montana-science-center/exhibit-laser-music-instrument/mechanical/ToF enclosure IR window holder.3mf

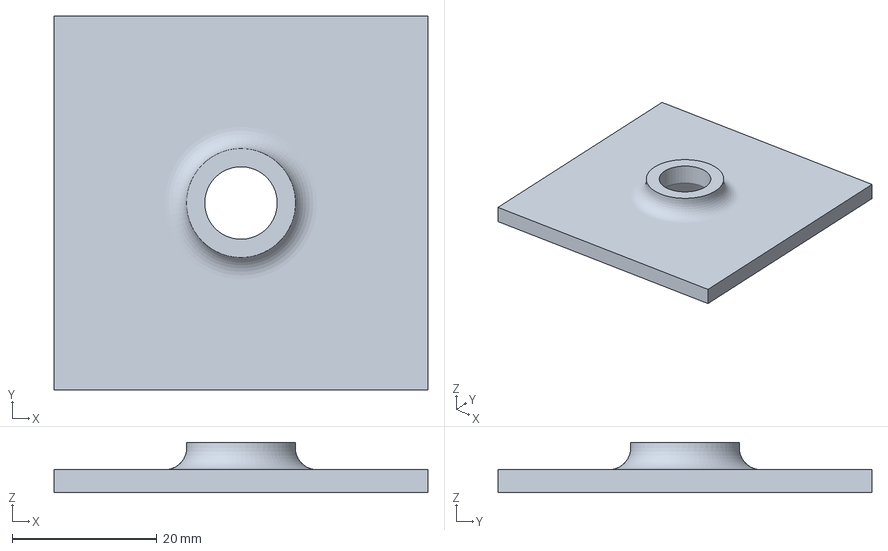
[picture p1: CAD file, 2022-08-08]
mechanical/ToF enclosure IR window holder.3mf
51.6 x 51.6 x 6.96 mm
