montana-science-center/exhibit-laser-music-instrument/pcb/phototransistor-circuit/phototransistor-circuit.step

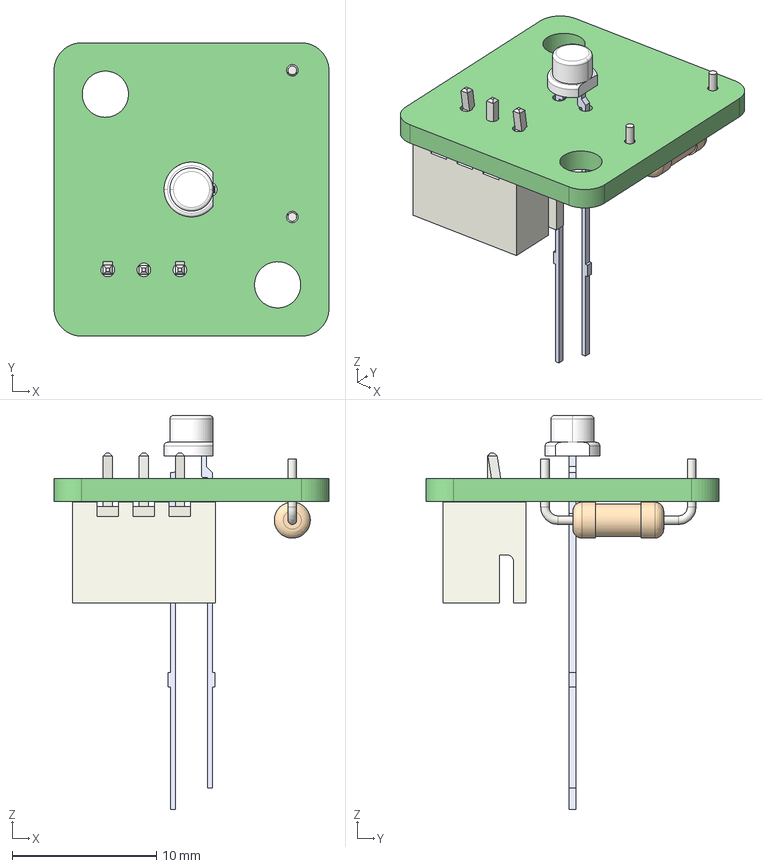
[picture p2: CAD file, 2022-05-28]
pcb/phototransistor-circuit/phototransistor-circuit.step
19.1 x 20.3 x 27.3 mm
phototransistor-circuit PCB
