montana-science-center/exhibit-laser-music-instrument/mechanical/ToF whammy bar enclosure.3mf

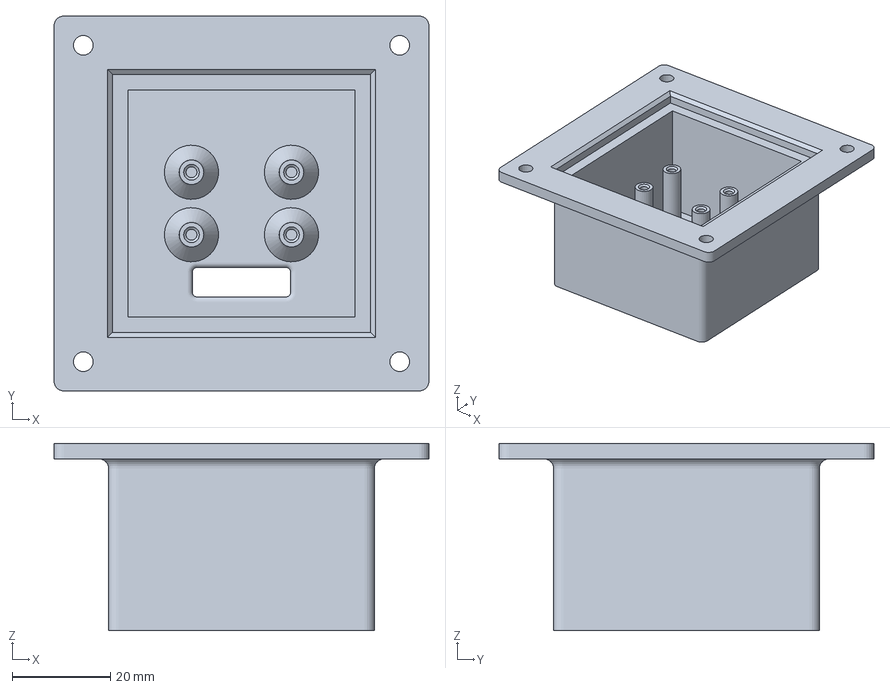
[picture p3: CAD file, 2022-08-08]
mechanical/ToF whammy bar enclosure.3mf
76.2 x 76.2 x 38.1 mm
