montana-science-center/exhibit-laser-music-instrument/mechanical/ToF whammy bar enclosure v5.3mf

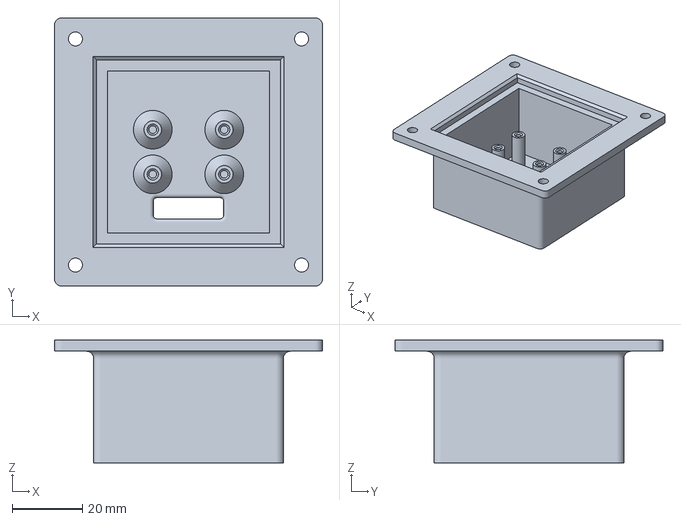
[picture p4: CAD file, 2022-08-08]
mechanical/ToF whammy bar enclosure v5.3mf
76.2 x 76.2 x 34.9 mm
