montana-science-center/exhibit-laser-music-instrument/mechanical/ToF whammy bar enclosure v3.step

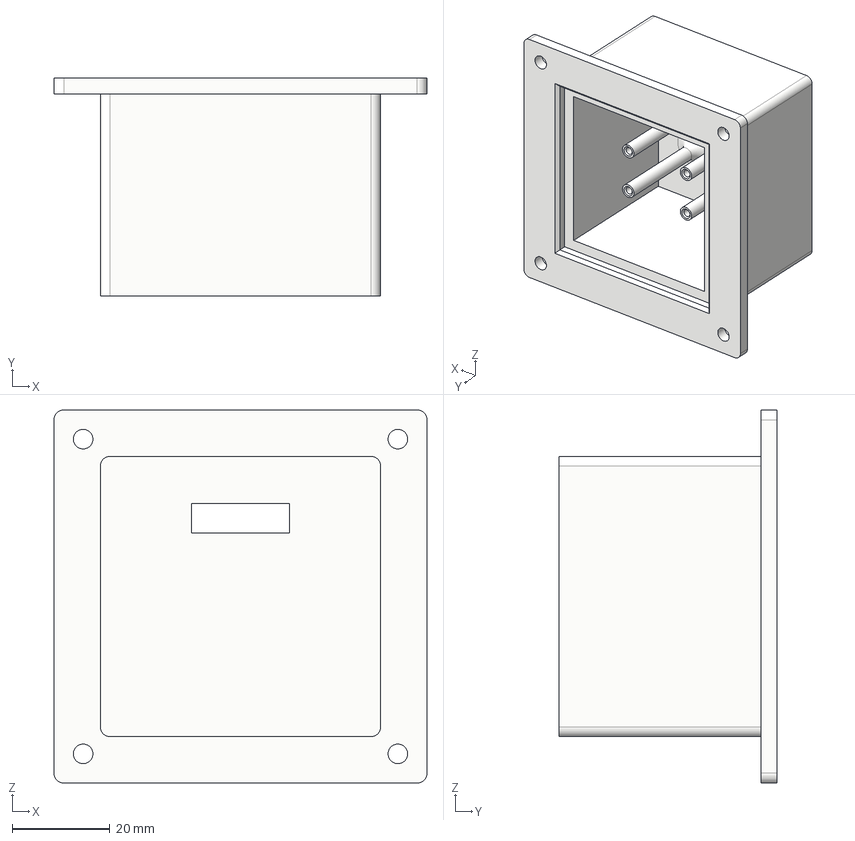
[picture p5: CAD file, 2022-08-08]
mechanical/ToF whammy bar enclosure v3.step
76.2 x 44.5 x 76.2 mm
