montana-science-center/exhibit-laser-music-instrument/mechanical/laser-module-holder-vlm-520-01-lpt.stl

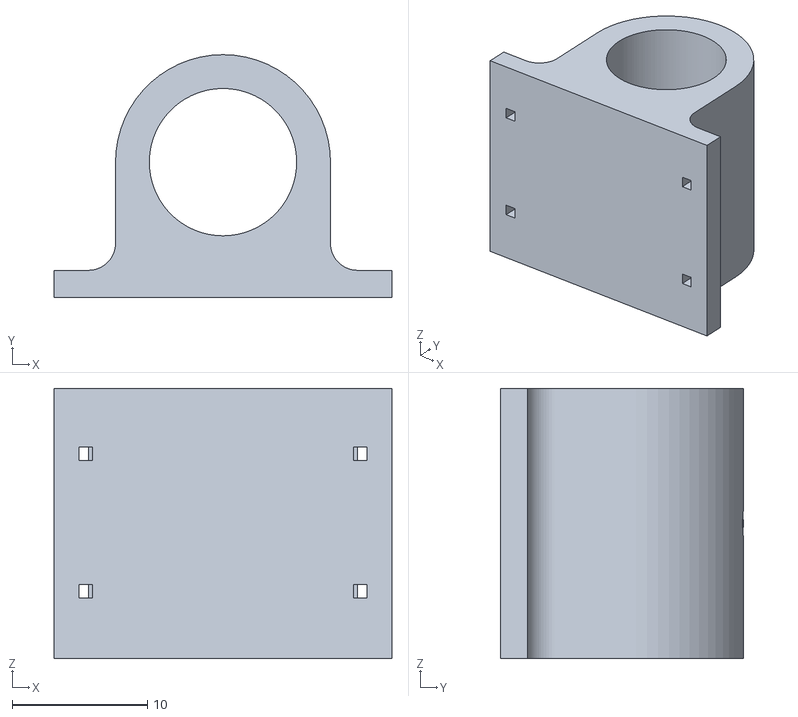
[picture p6: CAD file, 2022-05-13]
mechanical/laser-module-holder-vlm-520-01-lpt.stl
25.0 x 18.0 x 20.0
