montana-science-center/exhibit-laser-music-instrument/(list of files, cad)

Other CAD files:
mechanical/ToF whammy bar enclosure v6.stl
mechanical/5396 Adafruit VL53L4CD.f3d
mechanical/ToF enclosure IR window holder.stl
mechanical/ToF whammy bar enclosure v3.stl
mechanical/ToF whammy bar enclosure v5.stl
