montana-science-center/exhibit-laser-music-instrument/pcb/mainboard/mainboard.kicad_pcb

## KiCad design pcb/mainboard/mainboard.kicad_pcb (2022-06-05)

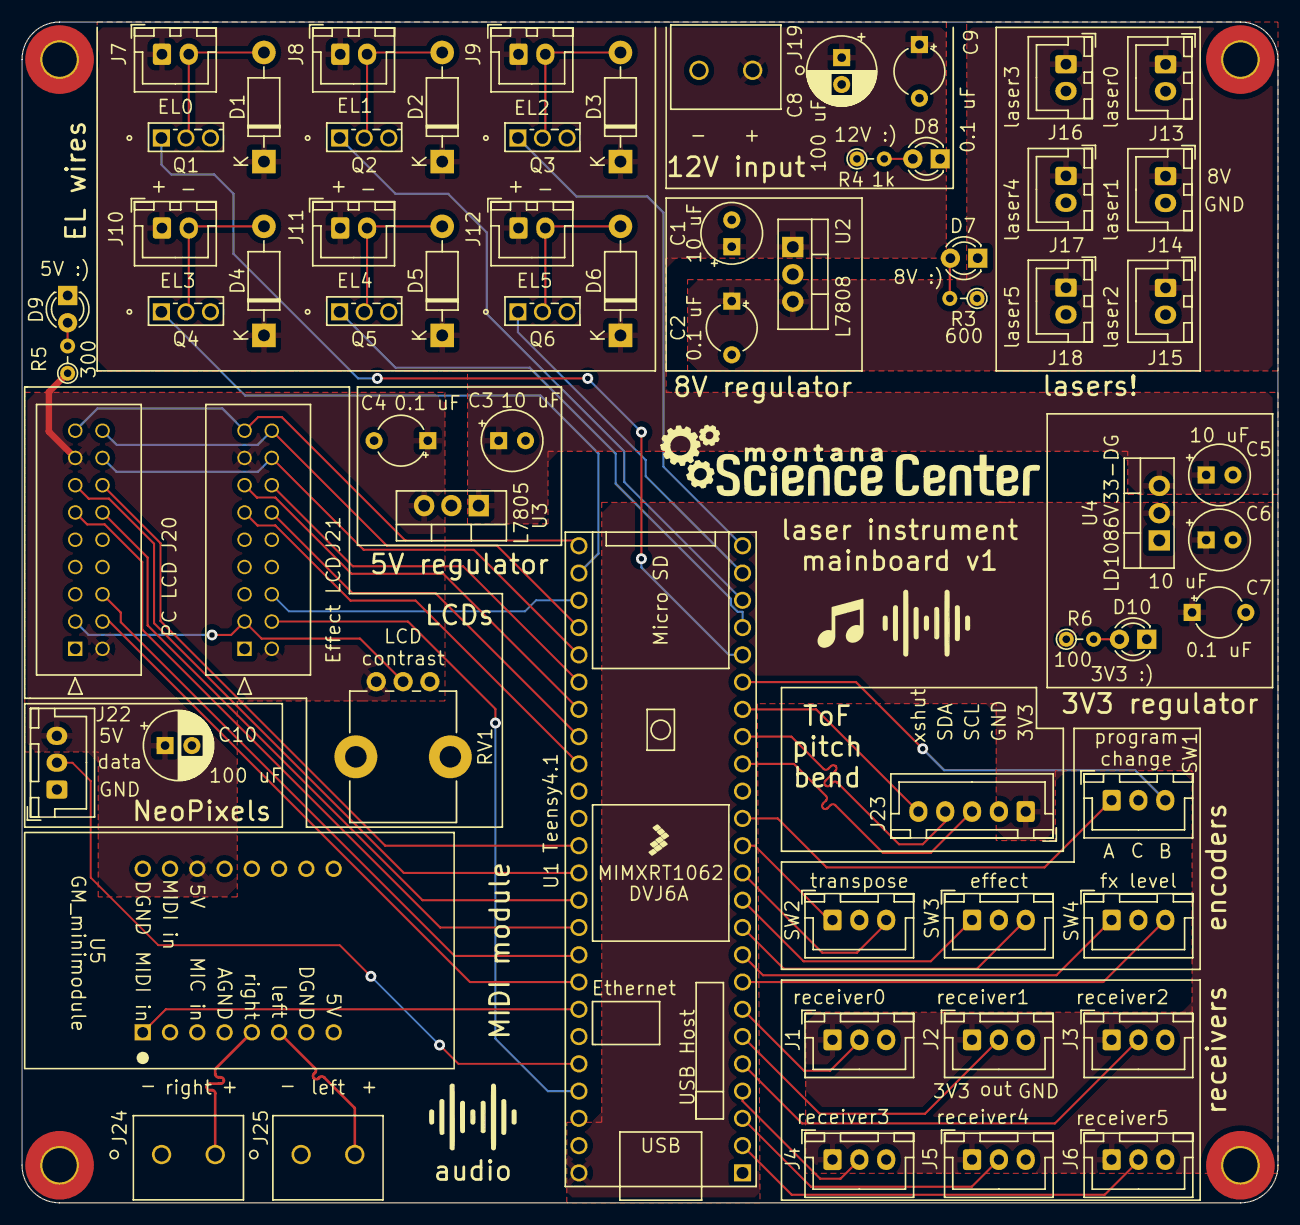
[picture p9: board mainboard.kicad_pcb from above]

Board: 2 copper layers, 117.0 x 110.0 mm, 69 parts (0 on the bottom side), 58 nets.

Parts:
C1, C3, C5, C6: 10 uF; CP_Radial_Tantal_D5.5mm_P2.50mm
C2, C4, C7, C9: 0.1 uF; CP_Radial_Tantal_D4.5mm_P5.00mm
C8, C10: 100 uF; CP_Radial_D6.3mm_P2.50mm
D1, D2, D3, D4, D5, D6: 1N4001; D_DO-41_SOD81_P10.16mm_Horizontal
D7, D8, D9, D10: LED; LED_D3.0mm_Clear
H1, H2, H3, H4: MountingHole_Pad; MountingHole_3.2mm_M3_Pad_TopBottom
J1: receiver0; JST_XH_B3B-XH-A_1x03_P2.50mm_Vertical
J2: receiver1; JST_XH_B3B-XH-A_1x03_P2.50mm_Vertical
J3: receiver2; JST_XH_B3B-XH-A_1x03_P2.50mm_Vertical
J4: receiver3; JST_XH_B3B-XH-A_1x03_P2.50mm_Vertical
J5: receiver4; JST_XH_B3B-XH-A_1x03_P2.50mm_Vertical
J6: receiver5; JST_XH_B3B-XH-A_1x03_P2.50mm_Vertical
J7, J8, J9, J10, J11, J12: el_connector; JST_XH_B2B-XH-A_1x02_P2.50mm_Vertical
J13: laser0; JST_XH_B2B-XH-A_1x02_P2.50mm_Vertical
J14: laser1; JST_XH_B2B-XH-A_1x02_P2.50mm_Vertical
J15: laser2; JST_XH_B2B-XH-A_1x02_P2.50mm_Vertical
J16: laser3; JST_XH_B2B-XH-A_1x02_P2.50mm_Vertical
J17: laser4; JST_XH_B2B-XH-A_1x02_P2.50mm_Vertical
J18: laser5; JST_XH_B2B-XH-A_1x02_P2.50mm_Vertical
J19: 12V_input; Wurth-691137710002
J20: PC LCD; Molex-901301118
J21: Effect LCD; Molex-901301118
J22: NeoPixel connector; JST_XH_B3B-XH-A_1x03_P2.50mm_Vertical
J23: VL53L4CD connector; JST_XH_B5B-XH-A_1x05_P2.50mm_Vertical
J24: right_audio; Wurth-691137710002
J25: left_audio; Wurth-691137710002
Q1, Q2, Q3, Q4, Q5, Q6: AOI4286
R3: 600; R_Axial_DIN0204_L3.6mm_D1.6mm_P2.54mm_Vertical
R4: 1k; R_Axial_DIN0204_L3.6mm_D1.6mm_P2.54mm_Vertical
R5: 300; R_Axial_DIN0204_L3.6mm_D1.6mm_P2.54mm_Vertical
R6: 100; R_Axial_DIN0204_L3.6mm_D1.6mm_P2.54mm_Vertical
RV1: 10k; Potentiometer_Bourns_PTV09A-1_Single_Vertical
SW1: program change encoder; JST_XH_B3B-XH-A_1x03_P2.50mm_Vertical
SW2: transpose encoder; JST_XH_B3B-XH-A_1x03_P2.50mm_Vertical
SW3: effect encoder; JST_XH_B3B-XH-A_1x03_P2.50mm_Vertical
SW4: effect level encoder; JST_XH_B3B-XH-A_1x03_P2.50mm_Vertical
U1: Teensy4.1; Teensy41
U2: L7808; TO-220-3_Vertical
U3: L7805; TO-220-3_Vertical
U4: LD1086V33-DG; TO-220-3_Vertical
U5: GM_minimodule; GM minimodule

Connections:
+3V3: C6.1, C7.1, J1.1, J2.1, J3.1, J4.1, J5.1, J6.1, J23.1, R6.1, U1.48 (VIN), U4.2 (OUT)
+5V: C4.1, C10.1, J20.2, J20.15, J21.2, J21.15, J22.3, R5.1, RV1.1, U3.3 (OUT), U5.11 (DVcc)
+8V: C2.1, J13.1, J14.1, J15.1, J16.1, J17.1, J18.1, R3.1, U2.3 (OUT)
+12V: C1.1, C3.1, C5.1, C8.1, C9.1, D1.1 (K), D2.1 (K), D3.1 (K), D4.1 (K), D5.1 (K), D6.1 (K), J7.1, J8.1, J9.1, J10.1, J11.1, J12.1, J19.1, R4.1, U2.1 (IN), U3.1 (IN), U4.3 (IN)
/LCDs/lcd_contrast: J20.3, J21.3, RV1.2
/MIDI module/left_audio: J25.2, U5.6 (LEFT_AUDIO)
/MIDI module/right_audio: J24.2, U5.5 (RIGHT_AUDIO)
/teensy/PC_LCD_D4: J20.11, U1.39 (17_A3_TX4_SDA1)
/teensy/PC_LCD_D5: J20.12, U1.38 (16_A2_RX4_SCL1)
/teensy/PC_LCD_D6: J20.13, U1.37 (15_A1_RX3_SPDIF_IN)
/teensy/PC_LCD_D7: J20.14, U1.36 (14_A0_TX3_SPDIF_OUT)
/teensy/PC_LCD_EN: J20.6, U1.40 (18_A4_SDA)
/teensy/PC_LCD_RS: J20.4, U1.41 (19_A5_SCL)
/teensy/SCL: J23.3, U1.16 (24_A10_TX6_SCL2)
/teensy/SDA: J23.4, U1.17 (25_A11_RX6_SDA2)
/teensy/blue_cathode: J20.18, J21.18, U1.28 (36_CS)
/teensy/effect_LCD_D4: J21.11, U1.33 (41_A17)
/teensy/effect_LCD_D5: J21.12, U1.32 (40_A16)
/teensy/effect_LCD_D6: J21.13, U1.31 (39_MISO1_OUT1A)
/teensy/effect_LCD_D7: J21.14, U1.30 (38_CS1_IN1)
/teensy/effect_LCD_EN: J21.6, U1.27 (35_TX8)
/teensy/effect_LCD_RS: J21.4, U1.45 (23_A9_CRX1_MCLK1)
/teensy/effect_encoder_A: SW3.1 (A), U1.11 (9_OUT1C)
/teensy/effect_encoder_B: SW3.3 (B), U1.10 (8_TX2_IN1)
/teensy/effect_level_encoder_A: SW4.1 (A), U1.9 (7_RX2_OUT1A)
/teensy/effect_level_encoder_B: SW4.3 (B), U1.8 (6_OUT1D)
/teensy/el_wire_0: Q1.1 (G), U1.20 (28_RX7)
/teensy/el_wire_1: Q2.1 (G), U1.22 (30_CRX3)
/teensy/el_wire_2: Q3.1 (G), U1.24 (32_OUT1B)
/teensy/el_wire_3: Q4.1 (G), U1.26 (34_RX8)
/teensy/el_wire_4: Q5.1 (G), U1.21 (29_TX7)
/teensy/el_wire_5: Q6.1 (G), U1.23 (31_CTX3)
/teensy/green_cathode: J20.17, J21.17, U1.25 (33_MCLK2)
/teensy/midi_output: U1.42 (20_A6_TX5_LRCLK1), U5.1 (MIDI_INPUT)
/teensy/neopixel_data: J22.2, U1.44 (22_A8_CTX1)
/teensy/pc_encoder_A: SW1.1 (A), U1.14 (12_MISO_MQSL)
/teensy/pc_encoder_B: SW1.3 (B), U1.19 (27_A13_SCK1)
/teensy/receiver_input_0: J1.2, U1.7 (5_IN2)
/teensy/receiver_input_1: J2.2, U1.6 (4_BCLK2)
/teensy/receiver_input_2: J3.2, U1.5 (3_LRCLK2)
/teensy/receiver_input_3: J4.2, U1.4 (2_OUT2)
/teensy/receiver_input_4: J5.2, U1.3 (1_TX1_CTX2_MISO1)
/teensy/receiver_input_5: J6.2, U1.2 (0_RX1_CRX2_CS1)
/teensy/red_cathode: J20.16, J21.16, U1.29 (37_CS)
/teensy/transpose_encoder_A: SW2.1 (A), U1.13 (11_MOSI_CTX1)
/teensy/transpose_encoder_B: SW2.3 (B), U1.12 (10_CS_MQSR)
/teensy/xshut: J23.5, U1.18 (26_A12_MOSI1)
GND: C1.2, C2.2, C3.2, C4.2, C5.2, C6.2, C7.2, C8.2, C9.2, C10.2, D7.1 (K), D8.1 (K), D9.1 (K), D10.1 (K), H1.1, H2.1, H3.1, H4.1, J1.3, J2.3, J3.3, J4.3, J5.3, J6.3, J13.2, J14.2, J15.2, J16.2, J17.2, J18.2, J19.2, J20.1, J20.5, J21.1, J21.5, J22.1, J23.2, J24.1, J25.1, Q1.3 (S), Q2.3 (S), Q3.3 (S), Q4.3 (S), Q5.3 (S), Q6.3 (S), RV1.3, SW1.2 (C), SW2.2 (C), SW3.2 (C), SW4.2 (C), U1.1 (GND), U1.34 (GND), U1.47 (GND), U2.2 (GND), U3.2 (GND), U4.1 (ADJ/GND), U5.4 (AGND), U5.7 (DGND), U5.9 (DGND), U5.15 (DGND)
unnamed: D1.2 (A), J7.2, Q1.2 (D)
unnamed: D2.2 (A), J8.2, Q2.2 (D)
unnamed: D3.2 (A), J9.2, Q3.2 (D)
unnamed: D4.2 (A), J10.2, Q4.2 (D)
unnamed: D5.2 (A), J11.2, Q5.2 (D)
unnamed: D6.2 (A), J12.2, Q6.2 (D)
unnamed: D7.2 (A), R3.2
unnamed: D8.2 (A), R4.2
unnamed: D9.2 (A), R5.2
unnamed: D10.2 (A), R6.2
