montana-science-center/exhibit-laser-music-instrument/src/main.cpp

// #include <Arduino.h>
#include <WProgram.h>
#include <Control_Surface.h>
#include <LiquidCrystal.h>
// #include <hd44780.h>
// #include <hd44780ioClass/hd44780_pinIO.h>
// #include <iostream>
#include <sstream>
#include <string>
#include <Arduino_Helpers.h>
#include <AH/Timing/MillisMicrosTimer.hpp>

#include "midiProgramNames.h"
#include "PBTimeOfFlightSensor.hpp"

#define MIDI_BAUD 31250
#define NUM_NOTES 6
#define NUM_PROGRAMS 114

class SelectorLCDDisplayCallback
{
private:
    LiquidCrystal lcd;
    const pin_t redPin;
    const pin_t greenPin;
    const pin_t bluePin;
    uint8_t redVal;
    uint8_t greenVal;
    uint8_t blueVal;
public:
    SelectorLCDDisplayCallback(): 
      lcd(LiquidCrystal(19, 18, 17, 16, 15, 14)),
      redPin(37), greenPin(33), bluePin(36),
      redVal(255), greenVal(50), blueVal(0)
      {}

    ~SelectorLCDDisplayCallback() {} 

    // Begin function is called once by Control Surface.
    // Use it to initialize everything.
    void begin() 
    {
      lcd.begin(16, 2);

      // invert the duty cycle because the LCD backlight is common anode
      redVal = map(redVal, 0, 255, 255, 0);
      greenVal = map(greenVal, 0, 255, 255, 0);
      blueVal = map(blueVal, 0, 255, 255, 0);

      // set rgb backlight color
      analogWrite(redPin, redVal);
      analogWrite(greenPin, greenVal);
      analogWrite(bluePin, blueVal);
    }
 
    // Update function is called continuously by Control Surface.
    // Use it to implement things like fading, blinking ...
    void update() {
      // Serial.println("in the update!");
    }
 
    // Update function with arguments is called when the setting
    // changes.
    // Use it to update the LEDs.
    void update(setting_t oldSetting, setting_t newSetting) 
    {
        lcd.clear();

        std::istringstream programName(PROGRAM_NAMES[newSetting]);

        std::string s;

        while (std::getline(programName, s, '\n'))
        {
          lcd.print(s.c_str());
          // Serial.println(s.c_str());
          lcd.setCursor(0, 1);
        }

    }
};

class SelectorSerialDisplayCallback
{
private:
    /* data */
public:
    SelectorSerialDisplayCallback()
    {

    };
    ~SelectorSerialDisplayCallback() {} ;

    // Begin function is called once by Control Surface.
    // Use it to initialize everything.
    void begin() 
    {
        // Serial.begin(9600);
    }
 
    // Update function is called continuously by Control Surface.
    // Use it to implement things like fading, blinking ...
    void update() {
      // Serial.println("in the update!");
    }
 
    // Update function with arguments is called when the setting
    // changes.
    // Use it to update the LEDs.
    void update(setting_t oldSetting, setting_t newSetting) 
    {
        // Program numbers start 1, but indexes start at 0, so we subtract 1
        // Serial.write(PROGRAM_NAMES[newSetting].c_str());
    }
};

void lightElWires(NoteButton lasers[], const uint8_t EL_WIRE_PINS[]) {

  for (size_t i = 0; i < NUM_NOTES; i++)
  {
    auto state = lasers[i].getButtonState();

    // The laser NoteButtons are inverted, so our logic for turning the EL wires on has to be inverted as well. A falling edge is "on", and a rising edge is "off".
    if (state == Button::Falling) {
      digitalWrite(EL_WIRE_PINS[i], HIGH);
    }
    else if (state == Button::Rising) {
      digitalWrite(EL_WIRE_PINS[i], LOW);
    }
  }
}

int main() {

  static HardwareSerialMIDI_Interface midiSynth = HardwareSerialMIDI_Interface(Serial5, MIDI_BAUD);

  const uint8_t EL_WIRE_PINS[NUM_NOTES] = {28, 30, 32, 34, 29, 31};

  

  static BidirectionalMIDI_Pipe loopbackPipe;
  static MIDI_Pipe synthTxPipe;

  /* Set up a loopback (MIDI out -> MIDI in) for the "control surface" 
    (the teensy) so we can read the MIDI messages we send. This allows us to
    light up EL wires when a note is sent, for example */
  Control_Surface | loopbackPipe | Control_Surface;

  // Connect MIDI out from the teensy to MIDI in of the synth module
  Control_Surface >> synthTxPipe >> midiSynth;

  static ProgramChanger<NUM_PROGRAMS> programChanger {
    {  // list of midi program numbers
      0,1,2,3,4,5,6,7,8,9,10,11,12,13,14,15,16,17,18,19,20,21,22,23,24,25,26,27,28,29,30,31,32,33,34,35,36,37,38,39,40,41,42,43,44,45,46,47,48,49,50,51,52,53,54,55,56,57,58,59,60,61,62,63,64,65,66,67,68,69,70,71,72,73,74,75,76,77,78,79,80,81,82,83,84,85,86,87,88,89,90,91,92,93,94,95,96,97,98,99,100,101,102,103,104,105,106,107,108,109,110,111,112,113,
    },
    CHANNEL_1, // MIDI channel to use
  };

  
  // Set initial program to jazz electric guitar
  // programChanger.setInitialSelection(26);

  // static GenericEncoderSelector<NUM_PROGRAMS, SelectorLCDDisplayCallback> programSelector {
  //   programChanger,
  //   {},
  //   {12, 27},
  //   1,
  //   Wrap::Wrap,
  // };



  // static Transposer<-12, +12> transposer;

  // static EncoderSelector<transposer.getNumberOfBanks()> pitchSelector {
  //   transposer,
  //   {11, 10},
  //   1,
  //   Wrap::Wrap
  // };
  
  // PBTimeOfFlightSensor pitchBender {
  //   26,
  //   CHANNEL_1,
  // };

  static NoteButton lasers[NUM_NOTES] {
    {5, MIDI_Notes::Db(3)},
    {4, MIDI_Notes::Eb(3)},
    {3, MIDI_Notes::Gb(3)},
    {2, MIDI_Notes::Ab(3)},
    {1, MIDI_Notes::Bb(3)},
    {0, MIDI_Notes::Db(4)},
  };
  // static Bankable::NoteButton lasers[NUM_NOTES] {
  //   {transposer, 5, MIDI_Notes::Db(3)},
  //   {transposer, 4, MIDI_Notes::Eb(3)},
  //   {transposer, 3, MIDI_Notes::Gb(3)},
  //   {transposer, 2, MIDI_Notes::Ab(3)},
  //   {transposer, 1, MIDI_Notes::Bb(3)},
  //   {transposer, 0, MIDI_Notes::Db(4)},
  // };
  for (auto &&laser : lasers)
  {
    laser.invert();
  }

  Timer<millis> heartbeatTimer = 250;

  // TODO: for some reason, bankable NoteLEDs were not working right. I could only get one el wire to work. Non-bankable NoteLEDs worked just fine. For now, I'm turning the el wires on by checking button state instead of listening for midi notes
  // static Bankable::NoteLED<transposer.getNumberOfBanks()> elWire1 {
  //   .bank = transposer, .pin = 2, .address = MIDI_Notes::Db(3),
  // };
  // static Bankable::NoteLED<transposer.getNumberOfBanks()> elWire2 {
  //   .bank = transposer, .pin = 3, .address = MIDI_Notes::Eb(3),
  // };
  // static Bankable::NoteLED<transposer.getNumberOfBanks()> elWire3 {
  //   .bank = transposer, .pin = 4, .address = MIDI_Notes::Gb(3),
  // };
  
  
  for (auto &&elWirePin : EL_WIRE_PINS)
  {
    pinMode(elWirePin, OUTPUT);
  }

  pinMode(LED_BUILTIN, OUTPUT);

  // Serial.begin(9600);

  // CCPotentiometer effectPot {
  //   A12,
  //   {MIDI_CC::Effects_1}
  // };


  Control_Surface.begin();

  // program 25 is nylon-string guitar
  programChanger.select(25);

  // Set reverb type of delay
  // Control_Surface.sendControlChange({MIDI_CC::General_Purpose_Controller_5, CHANNEL_1}, 0x03);

  // Control_Surface.sendControlChange(MIDI_CC::Effects_1, 0x7f);

  // uint8_t sysex[] = {0x40, 0x01, 0x34, 0x1};
  
  // Control_Surface.sendSysEx(sysex);

  while(1) {
    Control_Surface.loop();

    lightElWires(lasers, EL_WIRE_PINS);

    if (heartbeatTimer) {
      digitalWrite(LED_BUILTIN, digitalRead(LED_BUILTIN) ? LOW : HIGH);
    }

    // Serial.println(effectEncoder.getValue());


  }
}


// TODO: set pull-down resistors on EL wire pins just to be safe?
