montana-science-center/exhibit-laser-music-instrument/(commit log)

2022-03-28 Laser module holder for solderless breadboard
    I'm using this to attach the laser modules to a breadboard to keep them
    in place while prototyping.
    [laser-module-holder.scad, laser-module-holder.stl]
2022-03-28 minor code cleanup
    Reduced some unnecessary duplication
    [laser-module-holder.scad]
2022-05-10 Transition from Arduino to Teensy and Control-Surface library
2022-05-10 Update dimensions for larger laser modules
    The "industrial" laser modules from Quarton are a different size than
    the "economical" laser modules.
    [laser-module-holder.scad]
2022-05-10 add stl for laser modules
    [laser-module-holder-vlm-520-01-lpt.stl]
2022-05-11 add 6 lasers for penatonic scale
2022-05-11 Update hardware serial port
    I put a different synth module on the breadboard, and I decided to use a
    different pin for midi tx for convenience
2022-05-11 add rotary encoder for program changes; remove old code
2022-05-13 initial commit of phototransistor pcb
    [phototransistor-circuit.kicad_pcb, phototransistor-circuit.kicad_sch]
2022-05-13 move silkscreen label
    [phototransistor-circuit.kicad_pcb]
2022-05-13 route traces
    [phototransistor-circuit.kicad_pcb]
2022-05-13 Fix phototransistor footprint
    - Added solder mask keepout area on the bottom layer so there are pads
    to solder to.
2022-05-13 update transistor footprint
    [phototransistor-circuit.kicad_pcb]
2022-05-13 add 3d models; update to bigger jst connector
    The previous JST connector didn't accept 22 AWG wire.
    [phototransistor-circuit.kicad_pcb]
2022-05-13 add dimensions to pcb drawing
    [phototransistor-circuit.kicad_pcb]
2022-05-14 add transpose rotary encoder
2022-05-16 make pcb smaller
    [phototransistor-circuit.kicad_pcb]
2022-05-16 change vcc to 3v3
    [phototransistor-circuit.kicad_sch]
2022-05-16 update connector footprint to b3b-xh connector
    [phototransistor-circuit.kicad_sch]
2022-05-16 update silkscreens
    [phototransistor-circuit.kicad_pcb]
2022-05-16 Make the board look pretty
    - add silkscreen branding
    - change 3d models from wrl to step so I could export the whole board to
    step
    [phototransistor-circuit.kicad_pcb]
2022-05-16 add step file rendering
    [phototransistor-circuit.step]
2022-05-16 add msc logo footprints
2022-05-16 remove old laser module holder stl
    [laser-module-holder.stl]
2022-05-16 add dimensions between mounting hole centers and board edges
    [phototransistor-circuit.kicad_pcb]
2022-05-17 update DRC; generate gerbers
    [phototransistor-circuit-B_Cu.gbl, phototransistor-circuit-B_Mask.gbs, phototransistor-circuit-B_Paste.gbp, phototransistor-circuit-B_Silkscreen.gbo, phototransistor-circuit-Edge_Cuts.gm1, phototransistor-circuit-F_Cu.gtl, phototransistor-circuit-F_Mask.gts, phototransistor-circuit-F_Paste.gtp]
2022-05-25 light up EL wires on note press
2022-05-25 remove print statement
2022-05-26 add VL53L4CD-based time-of-flight pitch bend sensor
2022-05-26 change VL53L4CD xshut pin number
2022-05-26 add heartbeat led
2022-05-28 add teensy symbol/footprint
2022-05-28 Update 3D model of phototransistor
    The component sits about 1.5 mm above the PCB, so I moved the model up
    [phototransistor-circuit.kicad_pcb, phototransistor-circuit.step]
2022-06-05 add finished mainboard
    [VL53L4CD-connector.kicad_sch, el-wire-driver.kicad_sch, encoders.kicad_sch, laser-modules.kicad_sch, lcds.kicad_sch, led-rings.kicad_sch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]
2022-06-05 fork teensy repos so I can make changes
2022-06-10 update pins for pcb
2022-06-12 Improve ToF whammy bar code
    - use the right range for pitch bend values...
    - add an exponential moving average filter for to smooth changes
    - "spring back" to zero pitch bend when not being used
2022-06-29 fix order of notes
    [main.cpp]
2022-08-08 enclosure for whammy bar sensor
    [5396 Adafruit VL53L4CD.f3d, ToF enclosure IR window holder.3mf, ToF enclosure IR window holder.stl, ToF whammy bar enclosure v3.step, ToF whammy bar enclosure v3.stl, ToF whammy bar enclosure v5.3mf, ToF whammy bar enclosure v5.stl, ToF whammy bar enclosure v6.stl]
2024-02-18 disable rotary encoders
    The program-change encoder was causing issues and making the program
    hang or crash. Disabling all encoderes for now so the controller is
    hopefully stable.
    [main.cpp]
2024-03-17 create level translator
    The new optical rotary encoders use 5V logic levels, but the teensy only
    supports 3.3V.
    [level-translator.kicad_pcb, level-translator.kicad_sch]
