montana-science-center/exhibit-laser-music-instrument/(notices)

Notices in the files:
pcb/level-translator/level-translator.kicad_pcb:
License: CC-BY-SA-4.0
parts and their libraries:
Copyright 2021 Accelerated Designs. All rights reserved.
